system76/virgo/README.md

# System76 Virgo Laptop Project

This repository contains the KiCad electrical design of the System76 Virgo laptop.

## LICENSE

Hardware design files produced by System76 are licensed [CERN-OHL-S-2.0](./LICENSE-HARDWARE).
This license is recommended for open hardware by a number of organizations, and
can be seen as the hardware equivalent of using the GPLv3 license on software.

Software source files produced by System76 are licensed [GPL-3.0-only](./LICENSE-SOFTWARE).
To disambiguate the licensing, these files will also have an SPDX identifier.

Third party files of varying licenses, compatible with redistribution, will be
included in the third-party folder, with a note of their proper license.
