system76/virgo/(list of files, cad)

Other CAD files:
pcb-keyboard/models/c-2-1734839-4-c-3d.stp
pcb-rpl-uph/models/PTN5110.step
pcb-keyboard/models/Sprintek Nub v9.step
pcb-rpl-uph/models/1003-002-01100.stp
pcb-keyboard/models/LED_1515.step
pcb-keyboard/models/CPG142501DXX_keycap.step
pcb-keyboard/models/CPG142501DXX v3.step
pcb-keyboard/models/LED_1515.FCStd
pcb-rpl-uph/models/PTN5110.FCStd
