system76/virgo/(threads)

Thread 1 (2023-07-13):

These design files seem to be incomplete

i3lue-at-work, 2023-07-13:
Hi,
Perhaps I am confused or doing something wrong.
However, when I tried to open these design files it looks like the PCB is un-routed and the schematic is incomplete too.

leviport, 2023-07-13:
This is a very early work in progress. Incompleteness is to be expected at this time.

Closed 2023-07-13.

Thread 3 (2023-07-15):

Laptop design only supports backdoored CPUs (Intel, AMD)

donotsdubba, 2023-07-15:
Hello,

I think System76, much like FrameWork, has a lot of potential both as businesses and in providing products that serve individuals and public worldwide well.

That being said, this project being marketed as """open""" is WRONG, since it is anything but "open" (let alone libre), much like the FrameWork products: while repairability and modularity ARE important, they are USELESS, and even DECEITFUL, if all that is offered is a backdoored processor (Intel, AMD, ARM), **_shadowing_** ACTUAL non-backdoored, ACTUAL open design. (I.e. POWER9-based Talos II and Blackbird, PowerPC-based powerpc-notebook.org project, which also have schematics and everything else. There's also the LibreSoC project.)

For those that don't know what I mean by "backdoored processor", look no further than Intel's ME and AMD's PSP. ARM devices have also the exact same issues. This is a serious issue that applies to ALL Intel processors ever since the Core 2 Duo (you can fix the Core 2 Duo, but none of the i3/5/7/9 processors nor the Xeons), and ALL AMD processors since circa 2011.

I understand the STRUGGLE of keeping a business viable, but do NOT deceive your way through things. Please. RISC-V processors, aside POWER or PowerPC processors, also can work. (And please avoid POWER10, as Raptor did for their Talos line, since it is also compromised the same way as the other backdoored ones.)

I am more than open to hear and discuss your thoughts and reasonings on things. That being said, my points (sadly) will still apply regardless.

Thank you for listening.

Closed 2023-07-15.

Thread 12 (2024-07-24):

Dear Soller, Start behaving like an OSHW developer if you want to be one

Kreyren, 2024-07-24:
@jackpot51 You seem to claim that this will be [the most open modern x86 motherboard design](https://fosstodon.org/@soller/110697772188786089), but it's been over a year and the project is just a kicad project file with some bare minimal schematics and gerbers with placed footprints without routing while constantly shilling the project on foostodon.. This is not open-source hardware behavior it's proprietary with extra steps.

Sync the changes and engage with the community on the decisions on what components to use and how to address the problems and overall lead the project as if it was OSHW project with full transparency instead of it being internal-only.

leviport, 2024-07-24:
What you see in this repo is the current state of the project. Your assumption that progress has continued, but we've kept it to ourselves, is erroneous and highly uncharitable.

While this github org doesn't have its own code of conduct, you should assume that the one in the Pop!\_OS org applies to this one as well: https://github.com/pop-os/code-of-conduct. Your accusatory post is in breach of rules 1 and 4. You will receive no further warnings.

Kreyren, 2024-07-24:
> Your assumption that progress has continued, but we've kept it to ourselves, is erroneous and highly uncharitable. -- @leviport (https://github.com/system76/virgo/issues/12#issuecomment-2247951470)

Seems clearly evident considering what was posted in https://fosstodon.org/@soller/110708176613574187 (and other posts..) which appears to be just an information post about what decisions were taken internally as neither of this seemed to have been discussed outside of System76 and i couldn't find any kind of engagement with the community on this project.

The motivation to bring this up as an issue is that getting footprints and documentation to make OSHW x86 systems is very difficult to do in an OSHW-friendly way where it seems that S76 wants to address this which would enable more projects alike so not engaging with the community is quite unfortunate.

> While this github org doesn't have its own code of conduct, you should assume that the one in the Pop!_OS org applies to this one as well: [pop-os/code-of-conduct](https://github.com/pop-os/code-of-conduct). Your accusatory post is in breach of rules 1 and 4. You will receive no further warnings. -- @leviport (https://github.com/system76/virgo/issues/12#issuecomment-2247951470)

Do you really feel like this is an appropriate sentence to sent? It's threatening, toxic and bad taste.
I submitted what i believe is a valid and objective criticism and you decided to be an asshole and trying to make me feel small by making it seem like if i say anything slightly negative about S76 that there will be negative consequences.

Seriously.. what the fuck is wrong with you, please reflect on your actions prior to writing any more comments. OSHW community benefits the best when everyone is treated equally without leadership hierarchy.

leviport, 2024-07-24:
I can tell you're worked up, so I will not block you for the additional CoC violations you racked up in that reply. So I guess I lied, because this one is actually the final warning. This thread is locked. We welcome additional involvement, but you must abide by our CoC.

Asserting that System76 doesn't engage with the community is utter nonsense, as evidenced by all of our other projects. They speak for themselves, so I don't even feel the need to elaborate on this point.

I understand that the incompleteness of the Virgo project is frustrating, but accusations of obfuscation and "not acting like an OSHW developer" are not conducive to healthy collaboration. You could have just asked if this repo is up-to-date with the latest progress (the answer is yes).

Please, take a walk, come back later, and we'd love to consider any input you have on this project. It is still very young, and it's currently not our top priority, so community involvement would be very welcome. I do not wish to be a tyrant, but I will probably resemble one to any who disrespects my colleagues and breaks our CoC.

Closed 2024-07-24.
