system76/virgo/(commit log)

2023-07-11 Add scripts and data for generating KiCad footprint from BGA
    [RPL_UPH_FCBGA1744.csv]
2023-07-11 Add PCB project
    [virgo-motherboard.kicad_pcb, virgo-motherboard.kicad_sch]
2023-07-12 Group some pins
    [RPL_UPH_FCBGA1744.csv]
2023-07-12 Organize more BGA pins
    [CAMERA.csv, CFG.csv, CNVI.csv, DDR.csv, DISPLAY.csv, GPD.csv, GPP_A.csv, GPP_B.csv]
2023-07-12 Run check as part of make
    [TODO.csv, VSS.csv]
2023-07-12 Organize display, pcie clocks, and tcp by pairs
    [DISPLAY.csv, PCIE_CLK.csv, TCP.csv]
2023-07-12 Select DDR5 pins, split A and B channels
    [DDR.csv, DDR_A.csv, DDR_B.csv]
2023-07-12 Add SSD and USB-A schematic pages
    [ssd.kicad_sch, usb-a.kicad_sch, virgo-motherboard.kicad_sch]
2023-07-12 Rearrange DDR pins, add SATA and USB3 pins
    [CNVI.csv, DDR_A.csv, DDR_B.csv, DDR_MISC.csv, PCIE.csv, SATA.csv, USB3.csv]
2023-07-12 Move some GPIO pins to interface-specific units
    [CNVI.csv, EDP.csv, ESPI.csv, GPP_A.csv, GPP_D.csv, GPP_F.csv, GPP_H.csv, HDMI.csv]
2023-07-12 Rename motherboard project, add models and footprints for M.2, USB-A, and USB-C
    [1003-002-01100.stp, M-12401610E42A-REVT2.stp, M2_M_c-1-2199119-5-c-3d.stp, ssd.kicad_sch, usb-a.kicad_sch, virgo-motherboard.kicad_pcb, virgo-rpl-uph.kicad_pcb, virgo-rpl-uph.kicad_sch]
2023-07-12 Split out PCIEx4, TCP, USB-A, and move more HDMI signals
    [GPP_A.csv, GPP_H.csv, HDMI.csv, PCIEX4.csv, PCIEX4_A.csv, PCIEX4_B.csv, PCIEX4_MISC.csv, PCIE_CLK.csv]
2023-07-12 Move all eDP pins
    [EDP.csv, GPP_E.csv]
2023-07-12 Move all CNVi signals
    [CNVI.csv, GPP_H.csv]
2023-07-13 Add external ports
    [10157422-002RHLF.stp, audio.kicad_sch, ddr5.kicad_sch, ethernet.kicad_sch, hdmi.kicad_sch, sd.kicad_sch, usb-a.kicad_sch, usb-c.kicad_sch]
2023-07-13 Add ethernet
    [ethernet.kicad_sch, virgo-rpl-uph.kicad_pcb]
2023-07-13 Connect SSD data signals
    [cpu_pciex4_a.kicad_sch, cpu_pciex4_b.kicad_sch, virgo-rpl-uph.kicad_pcb]
2023-07-13 Set DDR5 symbol pin names and electrical types
    [ddr5.kicad_sch, ssd.kicad_sch, usb-a.kicad_sch, virgo-rpl-uph.kicad_sch]
2023-07-14 Change hardware license to CERN-OHL-S-2.0, reorganize to clarify licenses
    [M-12401610E42A-REVT2.stp, M2_M_c-1-2199119-5-c-3d.stp, virgo-rpl-uph.kicad_pcb]
2023-07-15 Connect CPU HDMI to port
    [cpu-hdmi.kicad_sch, hdmi.kicad_sch, virgo-rpl-uph.kicad_pcb]
2023-07-15 Connect USB-A and USB-C data
    [cpu_hdmi.kicad_sch, cpu_tcp0.kicad_sch, cpu_tcp1.kicad_sch, cpu_tcp2.kicad_sch, cpu_tcp3.kicad_sch, cpu_usb_a_1.kicad_sch, cpu_usb_a_2.kicad_sch, usb-c.kicad_sch]
2023-07-15 Connect DDR5 address and data
    [cpu_ddr_a.kicad_sch, cpu_ddr_b.kicad_sch, ddr5.kicad_sch, virgo-rpl-uph.kicad_pcb]
2023-07-17 Hook up the remaining DDR5 signals, and both CPU and DDR5 VSS
    [cpu_ddr_a.kicad_sch, cpu_vss.kicad_sch, ddr5.kicad_sch, virgo-rpl-uph.kicad_pcb, virgo-rpl-uph.kicad_sch]
2023-07-17 Clean up DDR5 connection in schematic
    [virgo-rpl-uph.kicad_pcb, virgo-rpl-uph.kicad_sch]
2023-07-17 Remove extra DC block caps on M.2 PCIe signals
    [cpu_pciex4_a.kicad_sch, cpu_pciex4_b.kicad_sch, virgo-rpl-uph.kicad_pcb]
2023-07-19 edp cable drawing
    [cable_edp_caii30.kicad_sch]
2023-07-19 add courtyard to CPU
    [virgo-rpl-uph.kicad_pcb]
2023-07-26 add initial design rules and stack
    [usb-c.kicad_sch, virgo-rpl-uph.kicad_pcb]
2023-07-26 add display connector
    [display.kicad_sch, virgo-rpl-uph.kicad_pcb, virgo-rpl-uph.kicad_sch]
2023-07-26 refactor CPU symbol
    [DDR_A.csv, DDR_B.csv, DDR_MISC.csv, EDP.csv, ESPI.csv, TCP.csv, TCP0.csv, TCP1.csv]
2023-07-31 refactor much of CPU schematic symbol
    [CAMERA.csv, CNVI.csv, DDI.csv, DDR_A.csv, DDR_B.csv, DDR_MISC.csv, EDP.csv, GPP_A.csv]
2023-08-03 Add keyboard PCB
    [CPG142501DXX v3.step, CPG142501DXX_keycap.step, LED_1515.FCStd, LED_1515.step, Sprintek Nub v9.step, c-2-1734839-4-c-3d.stp, mountingholes.kicad_sch, power.kicad_sch]
2023-08-03 Add MEC1521 pinout, update script to generate BGA automatically
    [ALL.csv]
2023-08-03 Generate MEC1521 symbol and footprint
2023-08-03 Add bigger offset to EC symbol
    [ALL.csv]
2023-08-04 Spacing changes to virgo keyboard
    [mountingholes.kicad_sch, virgo-keyboard-test.kicad_sch]
2023-08-04 Add EC schematic page
    [ALL.csv, ddr5.kicad_sch, display.kicad_sch, ec.kicad_sch, virgo-rpl-uph.kicad_sch]
2023-08-04 Fix EC pitch and add package boundaries
    [ALL.csv, ddr5.kicad_sch, ec.kicad_sch, virgo-rpl-uph.kicad_pcb]
2023-08-15 charger work in progress also adds 1.1, 1.8 V supplies
    [charger.kicad_sch, cpu_pciex4.kicad_sch, cpu_power.kicad_sch, virgo-rpl-uph.kicad_sch]
2023-08-16 power PCB placements, fix resistor value on 1.1 V supply
    [cpu_power.kicad_sch, virgo-rpl-uph.kicad_pcb]
2023-08-24 USB PD input work in progress
    [PTN5110.FCStd, PTN5110.step, charger.kicad_sch, ec.kicad_sch, ssd.kicad_sch, usb-a.kicad_sch, usb-c.kicad_sch, virgo-rpl-uph.kicad_sch]
2023-08-24 I2C, etc to EC page
    [charger.kicad_sch, ec.kicad_sch, usb-c.kicad_sch, virgo-rpl-uph.kicad_sch]
2023-09-07 USB PD input work in progress, etc EC battery backed RTC supply
    [ec.kicad_sch]
2023-09-09 add VCCINAUX
    [VCCCORE.csv, VCCCORE_GT.csv, VCCGT.csv, VCCINAUX.csv, charger.kicad_sch, cpu_misc.kicad_sch, cpu_power.kicad_sch, ddr5.kicad_sch]
2023-09-09 VCCCORE, VCCGT WIP
    [charger.kicad_sch, cpu_ddi.kicad_sch, cpu_ddr.kicad_sch, cpu_misc.kicad_sch, cpu_pciex4.kicad_sch, cpu_power.kicad_sch, cpu_unused.kicad_sch, cpu_usb.kicad_sch]
2023-09-11 Connect I2C busses on EC page
    [ec.kicad_sch]
2023-09-25 core power work in progress
    [VCCINAUX.csv, VCC_MISC.csv, phase.kicad_sch, vcc_core_gt.kicad_sch]
